scottgchin/delta5_race_timer/(threads)

Thread 1 (2017-03-24):

Update RSSI trigger function

scottgchin, 2017-03-24:
Currently if the average RSSI is above the threshold limit (or lap trigger) this counts as a good lap read.  Look into using a rising edge detection or a peak detection to determine the trigger.  The trigger calibration could still set the minimum threshold required.

For reference:
https://www.tigoe.com/pcomp/code/arduinowiring/46/

howflyquad, 2017-05-20:
I think this is complete in the current version of the code using the rssiTriggerBandwidth value.

Closed 2017-05-29.

Thread 2 (2017-04-06):

Map and constrain the RSSI value

scottgchin, 2017-04-06:
The RSSI value can be over 255 which isn't handled well by i2c unless the number is conditioned.  Possibly use the map() and constrain() functions to keep the values within range.

shamshir1972, 2017-04-08:
scottgchin,
i've setup delta5 and got prob with python script. startstop.py seem to be not running at line 78 due to i2c device not present. Im using i2c device with address 14 (address of node 4 i2c) and channel 5860 (30). I got to delete other i2c device line and only remain the code for i2c address 14. Also at line 122 (while startstop==1) i got to remove other line not related to node 4 to get everything working. Please help me

scottgchin, 2017-04-08:
If I understand you correctly, you're only using 1 node and it is using slave address 14 correct?

You need to delete the references to the other nodes because the pi is stuck waiting for a response from the arduinos (which are not there)  If that is the case you'll need to make the following changes to the startstop.py file:

Delete lines 70-72
Delete lines  74-83
Delete lines  86-104
Delete lines 111-119
Delete lines 124-194
Delete lines 220-266

scottgchin, 2017-04-12:
The arduino file has been updated to ver 0.2 with adds the mapping and constrain functions to the RSSI read function.

Closed 2017-04-12.

Thread 20 (2017-06-28):

Move Race Timing Clock to the Python Script

howflyquad, 2017-06-28:
The race timing clock is currently javascript on the race page. It does not persist if the race director navigates away from the race page and then returns. Move the timing clock to a python function with socket io updates back to the race page as needed. This might involve needed a separate emit for each audio cue as well.

punkkills, 2017-06-28:
You could have a generic "play_cue" emit with some data describing which cue to play.

howflyquad, 2017-06-28:
True, that would be the better way to do it.

Should also tie in with #18

Thread 26 (2017-07-03):

Database Clears on System Power Cycle

howflyquad, 2017-07-03:
Database resets on a power cycle when it shouldn't.

howflyquad, 2017-07-03:
It looks like the systemd service run on startup was using a temp directory which was then cleared on a power cycle. The docs have been updated to make the working directory match the main repo directory. Some testing has shown the database to now persist after a hard power loss.

Closed 2017-07-03.

Thread 45 (2017-07-20):

Calibrated each node

sniperxnl, 2017-07-20:
Maby a idear,that we can calibrate each node, so the quality diffrence is not a issue anymore

jrob3rts, 2018-04-25:
I think this would be a brilliant fix / change if possible as we are seeing the variations in the boards are causing some mis reads.

Thread 50 (2017-10-15):

Discard or highlight falsey laps

ntgussoni, 2017-10-15:
Add a method to mark or directly discard falsey laps.
Add a minimum lap time value to the race config.

Eg. A lap for some track cannot be less than 5 seconds so we mark it in order to delete it easily.
We could also add a bulk delete button with those times

ntgussoni, 2017-10-15:
I'll do this feature when I have the time

scottgchin, 2017-10-15:
On the default GUI, you can already delete laps, there is an 'x' that shows up next to each lap.

Nandox7, 2018-06-16:
@ntgussoni did you end up doing anything?
I'm also interested in adding a feature to automatically discard false laps (less that n time).

ntgussoni, 2018-06-19:
I completely forgot about this. I hacen't used the timer in a while but this shouldn't be difficult to do.
Not promising anything, but i'll try to do it

Thread 54 (2018-01-01):

Automated Rasberry Pi images

spuder, 2018-01-01:
It would be nice to have a pre-built raspberry pi image.

pi-gen is the tool used to generate the pre built images on raspberrypi.org

https://github.com/RPi-Distro/pi-gen

scottgchin, 2018-01-01:
Sorry if I'm a bit slow, but help me understand what this does?
it creates an .img for easy installation?

spuder, 2018-01-01:
Correct, so instead of people needing to install the software manually, they just download a .img to a sd card, plug it in and everything is up and running.

Some example projects that ship pre-built images for raspberry-pi.

[octopi](https://octopi.octoprint.org/)
[astrobox](https://astroprint.zendesk.com/hc/en-us/articles/202638365-Raspberry-Pi-Flashing-the-AstroBox-image-onto-an-SD-card)

I'm interested in helping with this.

spuder, 2018-01-04:
The home assistant (hasbian) raspberry pi image is the best example. Steps to implement:

1. Fork the pi-gen image (I'll do this in my own fork for now, eventually it may be best to move it under a delta 5 organization)
2. Remove folders [stage 3,4,5] replace with own scripts to install and configure app
3. setup travis-ci to build a new image based on a schedule/event (weekly?, on merge to master?, whenever you feel like it)
4. Update documentation showing where to download images ([hasbian images](https://github.com/home-assistant/pi-gen/tree/v1.31) are 300-400mb which should be hostable on github)
5. Profit??

scottgchin, 2018-01-04:
Cool.  I'll take a look at it when I get a chance.  I already posted the latest image of my SD card on the facebook page to make it easier for people to install.

spuder, 2018-01-04:
I've nearly got the automated images working. They are on my delta5 branch in my fork. The bulk of the script is in step 3

https://github.com/spuder/pi-gen/tree/delta5

It is copied from the home-assistant project

https://github.com/home-assistant/pi-gen

spuder, 2018-01-05:
I've successfully got automated images building on my repo

https://github.com/spuder/pi-gen

    ./build-docker.sh

Depending on your internet speed, you will then have an image in about 30 minutes.

The image is idential to a stock raspbian with the following changes.

- source is cloned to /opt/delta5
- dedicated user to run service
- locale = US not GB (still buggy)
- nginx reverse proxy to forward port 80 to 5000
- i2c kernel modules

It will build a 456MB file. Use a program like etcher to drop it on an sd card, plug it in and wait 5 minutes and delta 5 will be running.

## Next steps

- Transfer git repo to delta 5 project ownership
- setup travis-ci to build images every time delta 5 has a new release
- document how to use

spuder, 2018-01-09:
I've got an image up on github. The biggest advantage to it is that it has UK keyboard and locale settings.

https://github.com/spuder/pi-gen/releases

scottgchin, 2018-01-13:
Sorry about the delay, Just now starting to go through this.  This looks pretty cool!  So how is the image creation triggered?  Is it each time there is a release?

spuder, 2018-01-13:
That part still hasn’t been automated yet. Currently you need to install
Docker and then run the build-docker.sh script.

I’ve manually uploaded two images to github so far

Depending on how frequently delta 5 is released will determine how to
automate the raspberry pi image with Travis ci.

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

h4rr21, 2018-02-01:
Hi spuder, I understand that part of the idea it's to make easy to deploy de code to the raspi.

But what about "https://resin.io" shouldn't be easy to deploy if delta5 runs in a docker container with resin.io rather than uploading a complete new image each time it releases a new one?

BTW I'm interested in helping to adopt CI tools in this project...

spuder, 2018-02-01:
There may be a place for resin.io, however that is more intended for IOT projects. Delta 5 is very often run without internet access. Also delta5 doesn't run in a docker container currently, it only uses docker to build the image that goes on the SD card.

As far as I'm concerned, the raspberry pi images are working, you can get them here:

https://github.com/spuder/pi-gen/releases

Since delta 5 isn't releasing new versions very often, there isn't a need net for a more automated update process (yet).

h4rr21, 2018-03-04:
What's the login user and password? For this images?

BoLtWD, 2018-09-27:
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

This is fantastic work to help someone get going as setting up the Pi can be daunting.

Thread 57 (2018-01-08):

Lipo Voltage Monitoring

jafc76, 2018-01-08:
Would be nice to have that option to check the Li-Po voltage and an alert when the voltage is low.
I know that it needs a PCB modification but could be easy to make.

dronemesh, 2018-01-27:
Im currently working on a new PCB design with all smd components which should be ready within a couple weeks. If you are interested

Thread 60 (2018-01-17):

How does it integrate with live time?

spuder, 2018-01-17:
I'm just learning what live time is. The documentation says

>Alternatively, to use your Delta5 Race Timer hardware with 3rd party timing software, replace each reference of 'delta5server' with 'timingserver' in the following instructions.

Does live time run on the raspberry pi?

There have been some facebook discussions around switching between the delta 5 server and live time. I'm trying to figure out if there is a way to run both services simultaneously and use a proxy to route network traffic based on the source url.

Could you elaborate on why there is a need for 2 different services to be running?

punkkills, 2018-01-18:
Livetime runs on a PC and communicates with the pi through the TimingServer.  The TimingServer does not have any more advanced features such as managing pilots and heats.  The delta5server is a race management tool.  It runs as a web app and provides a subset of the functionality of something like Livetime.  They have different requirements and goals so they are different apps.  They do run shared code for communicating with the arduinos.

Closed 2018-01-29.

Thread 77 (2018-04-09):

RSSI not working correctly

ManCubFPV, 2018-04-09:
I have everything built and programmed as instructed. When I'm the GUI for LiveTime it shows all the nodes at 570(+-5) and no changes or spikes when I power up a transmitter. What'd I do wrong?

ManCubFPV, 2018-04-09:
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

scottgchin, 2018-04-09:
Those RSSI values are really high; they are normally below 300.  The stranger part is that they all have the same value.

The working RSSI range on my unit is roughly 100-250.  With no vtx powered on, the RSSI floor is around 60-80.  Any chance you can provide details on the equipment you're using and how you have it wired?

scottgchin, 2018-04-09:
Looking at the image above. Connect the outside ground on the PCB to the receiver, that's the active ground.  It needs that ground for a common reference point.  I wrote that up in the description when the pcb was first released.   If you followed Deep Impacts video, he went back and clarified to connect all the pins.

ManCubFPV, 2018-04-09:
Thank you so much! I don't know how I missed that. Also thank you for all
the hard work on this and your quick responses.

Casey Pinochi
541-971-7763
Casey.Pinochi@gmail.com

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

scottgchin, 2018-04-09:
No problem.  Let me know if that fixes it, or if you come across any other issues.

ManCubFPV, 2018-04-09:
On a side note, know anyone that wants the v2 PCB? I have 6 extra

Casey Pinochi
541-971-7763
Casey.Pinochi@gmail.com

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

ManCubFPV, 2018-04-09:
I share Facebook with my good half. It's kind of a pain for me to use. You
can either text me at the number below or email me at the email below.

Casey Pinochi
541-971-7763
Casey.Pinochi@gmail.com

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

ManCubFPV, 2018-04-10:
is there anyway to pull the video feed from the delta 5?

On Mon, Apr 9, 2018 at 8:24 AM, Casey Pinochi <casey.pinochi@gmail.com>
wrote:

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

--

Casey Pinochi
530-228-6609
Casey.Pinochi@gmail.com

scottgchin, 2018-04-10:
Well... I haven't tried it yet, but I want to just to see what happens.  But, the premise of the timer is that away from the receivers, the RSSI would be really low and really high when the quad is passing over.  It's one of the reasons for not adding an antenna.  So at the far points of the track, I'm not sure the video would be very good.

Thread 81 (2018-08-01):

Improve phonetic readout of lap + time

fahrvergnuugen, 2018-08-01:
Right now the phonetic readout of the pilot plus lap plus time is a bit hard to comprehend because the lap number bleeds into the time.

**Example: "Paul lap one one minute five seconds"**

I believe this is the line responsible:

https://github.com/scottgchin/delta5_race_timer/blob/47a35739f8de409c27af11655828dc35512c076c/src/delta5server/templates/race.html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

I am going to try modifying this function on our timer to something like this (to be tested still):
```
		socket.on('phonetic_data', function (msg) {
			//	var $ttstest = msg.pilot + " lap " + msg.lap + " " + msg.phonetic;

			var phoneticLap="";
			switch(msg.lap){
				case 1: phoneticLap = "st"; break;
				case 2: phoneticLap = "nd"; break;
				case 3: phoneticLap = "rd"; break;
				default: phoneticLap = "th"; break;
			}
			var $ttstest = msg.pilot + msg.lap + phoneticLap + " lap " + msg.lap + " " + msg.phonetic;

			speak('<div class="speech">' + $ttstest + '</div> div.speech');
		})
```

That should hopefully cause it to say: **"Paul first lap one minute five seconds"**

Thread 82 (2018-08-01):

iOS speech support

fahrvergnuugen, 2018-08-01:
For some reason the speech doesn't work on iOS devices. I believe this can be fixed since https://responsivevoice.org works on iOS.

Cuxx, 2018-08-01:
It's a safari related problem. Sounds are working with Chrome.

DevertNet, 2018-12-11:
iOS needs a user interaction to allow speech.
I don't know why e.g. the play-button in the settings not work, but i have found a workaround:

Open src/delta5server/templates/layout.html.
After `{% block content %}{% endblock %}` add the following code in a new line:
`<a href="#" onclick="speak('<div class=timer>Ready</div>');">Allow iOS Speech</a><br /><br />`

You must click on "Allow iOS Speech" first, than speech works :)

scottgchin, 2018-12-11:
Cool.  I'll try it out when I get a chance.  It's an iOS issue where the user has to interface with the page before sound is allowed to play.

Thread 84 (2018-08-20):

list index out of range

spuder, 2018-08-20:
The delta5 timer was working yesterday, but today when I try and start it, the service exits with error `list index out of range`

```
journalctl -xe
.....
Aug 20 02:34:01 delta5 python[724]: No node at address 8
Aug 20 02:34:01 delta5 python[724]: Node FOUND at address 10
Aug 20 02:34:01 delta5 python[724]: Node FOUND at address 12
Aug 20 02:34:01 delta5 python[724]: Node FOUND at address 14
Aug 20 02:34:01 delta5 python[724]: No node at address 16
Aug 20 02:34:01 delta5 python[724]: No node at address 18
Aug 20 02:34:01 delta5 python[724]: No node at address 20
Aug 20 02:34:01 delta5 python[724]: No node at address 22
Aug 20 02:34:01 delta5 python[724]: Traceback (most recent call last):
Aug 20 02:34:01 delta5 python[724]:   File "server.py", line 33, in <module>
Aug 20 02:34:01 delta5 python[724]:     INTERFACE = get_hardware_interface()
Aug 20 02:34:01 delta5 python[724]:   File "../delta5interface/Delta5Interface.py", line 343, in get_hardware_interface
Aug 20 02:34:01 delta5 python[724]:     return Delta5Interface()
Aug 20 02:34:01 delta5 python[724]:   File "../delta5interface/Delta5Interface.py", line 104, in __init__
Aug 20 02:34:01 delta5 python[724]:     self.set_calibration_threshold(node.index, self.calibration_threshold)
Aug 20 02:34:01 delta5 python[724]:   File "../delta5interface/Delta5Interface.py", line 270, in set_calibration_threshold
Aug 20 02:34:01 delta5 python[724]:     node = self.nodes[node_index]
Aug 20 02:34:01 delta5 python[724]: IndexError: list index out of range
Aug 20 02:34:01 delta5 systemd[1]: delta5.service: Main process exited, code=exited, status=1/FAILURE
Aug 20 02:34:01 delta5 systemd[1]: delta5.service: Unit entered failed state.
Aug 20 02:34:01 delta5 systemd[1]: delta5.service: Failed with result 'exit-code'.
Aug 20 02:34:07 delta5 kernel: Voltage normalised (0x00000000)
```

Not sure how to recover from this. How does `self.nodes[node_index]` go out of range?

scottgchin, 2018-08-20:
It doesn't like that the first node is missing.  Check the connections on that node, it's not talking to the pi over i2c

Closed 2018-08-21.

Thread 85 (2018-08-21):

reset database doesn't work

spuder, 2018-08-21:
Running the latest code as of a couple of days ago. When I click 'reset database' it asks me to login and then refreshes the page, but the database didn't reset because I still see pilots and heats.

47a35739f8de409c27af11655828dc35512c076c

spuder, 2018-08-21:
Looking at the logs, it now gives me error

     'NoneType' object has no attribute 'pilot_id'

```
root@delta5:/opt/delta5# systemctl status delta5.service
● delta5.service - Delta5 Server
   Loaded: loaded (/lib/systemd/system/delta5.service; enabled; vendor preset: enabled)
   Active: active (running) since Tue 2018-08-21 01:47:26 UTC; 42s ago
 Main PID: 943 (python)
   CGroup: /system.slice/delta5.service
           ├─943 /usr/bin/python server.py
           └─949 /usr/bin/python server.py

Aug 21 01:48:05 delta5 python[943]:     return self.handlers[namespace][event](*args)
Aug 21 01:48:05 delta5 python[943]:   File "/usr/local/lib/python2.7/dist-packages/flask_socketio/__init__.py", line 2
Aug 21 01:48:05 delta5 python[943]:     *args)
Aug 21 01:48:05 delta5 python[943]:   File "/usr/local/lib/python2.7/dist-packages/flask_socketio/__init__.py", line 6
Aug 21 01:48:05 delta5 python[943]:     ret = handler()
Aug 21 01:48:05 delta5 python[943]:   File "server.py", line 258, in connect_handler
Aug 21 01:48:05 delta5 python[943]:     emit_leaderboard() # Race page, load leaderboard for current laps
Aug 21 01:48:05 delta5 python[943]:   File "server.py", line 721, in emit_leaderboard
Aug 21 01:48:05 delta5 python[943]:     heat_id=RACE.current_heat, node_index=node).first().pilot_id
Aug 21 01:48:05 delta5 python[943]: AttributeError: 'NoneType' object has no attribute 'pilot_id'
```

Cerberus74, 2018-08-26:
+1

Am experiencing same behaviour on a newly built set up.

Cerberus74, 2018-08-26:
Stopped service
Removed /home/pi/delta5_race_timer/src/deltaserver/database.db
Started service

Problem solved!

Thread 86 (2018-10-08):

Delete the database so you can start again if there is a problem the delta5server GUI.

BoLtWD, 2018-10-08:
I would like to see in the delta5server GUI a way to delete the database and restart the PI so you can start again if there is a problem.

Thread 88 (2018-11-05):

hacker's question

alto777, 2018-11-05:
I am delighted to find this excellent project.

In delta5node.ino it looks like there is a hard-coded i2cSlaveAddress. This is used for wire initialization, it is also printed for our convenience.

But there is also a mechanism for the master controller to interrogate the slave nodes for that address… but to do this, the address would already be known.

Car 54, what is your car number?

Or I am missing something probably. Is there a kind of master broadcast that is used to find all slaves?

alto777

scottgchin, 2018-11-07:
Not sure I understand what you're asking.

alto777, 2018-11-13:
Why is there a command to interrogate the slave for its address

when

in order to interrogate a slave, its address must already be known?

ntgussoni, 2018-11-13:
I guess it's because you can add N number of nodes with different IDs , and you don't need to change the main code if you do so. That's why it's "searching" for nodes in the BUS.

alto777, 2018-12-11:
Then I must not understand I2C.

Can an I2C slave respond to packets that do not know its address? I find "general call" googling, but don't see how it could be employed in any scanning process.

If you need to know the adderss of a slave to talk to it, why would one of the things you can ask it be its address?

I anticipate again being not understood, so another anaolgy: call 1-800-555-1212 and ask then what number you dialed. You already know!

a7

ntgussoni, 2018-12-11:
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

Here's an interesting reading.  https://howtomechatronics.com/tutorials/arduino/how-i2c-communication-works-and-how-to-use-it-with-arduino/

But long story short,  you need to know the address of the device in order to comunicate with it.

Imagine you add N numbers of nodes, each an everyone with a different address, if you don't have a way of finding them automatically then you'd have to enter each an everyone by hand so that the software recognizes them.
But instead you can scan a range of addresses (max of 8 in this case), and store them them whenever you get an ACK.
You don't know if the user is going to have 2, 4 , 8 or maybe just one. Plus, if we decide to support more, we can just go and add new addresses to the array.

https://github.com/scottgchin/delta5_race_timer/blob/47a35739f8de409c27af11655828dc35512c076c/src/delta5interface/Delta5Interface.py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

alto777, 2018-12-11:
Thank you. The READ_ADDRESS command appears to only be used to see if the device is there. Any other command would have sufficed. By either succeeding or failing the presence of a node can be determined.

Or I am still missing something - is there anything about READ_ADDRESS that makes it uniquely work for detecting?

The "report your own address" feature of a device that must be addressed to get a report seems odd.

a7

Thread 89 (2018-11-07):

Restore previous 'delta5node.ino'

ethomas997, 2018-11-07:
Commit d17dcdf43f90741d451240af1effb84ca40a5932 ("timing server LED") reverts the changes to 'delta5node.ino' that came in via the previous commit d0df60163cc21c1b55e4afff656acef83826c2ed ("Modified node to use freqMhzToRegVal() fn instead of table") for no apparent reason.  I think the [previous 'delta5node.ino'](https://github.com/scottgchin/delta5_race_timer/blob/d0df60163cc21c1b55e4afff656acef83826c2ed/src/delta5node/delta5node.ino) should be restored.

--ET

scottgchin, 2018-11-07:
It was updated because on the LiveTime version, the user can manually input the frequency.  If the user submitted a frequency that wasn't in the table the system would lock up.  Is there an issue with using the current freqMhzToRegVal() calculation?

scottgchin, 2018-11-07:
It should be restored now.

ethomas997, 2018-11-07:
Yes, looks good now; thx.

Closed 2018-11-07.

Thread 90 (2018-11-27):

Issue Getting Delta5 to work

blakermchale, 2018-11-27:
I've been trying to get the app to run by following the Software Setup Guide, but when in the settings this error keeps occurring.
This only happens in the settings, and I'm unable to add pilots or heats.
None of python files were changed after cloning

Any help would be appreciated.
Thanks.

```
Client connected
connect handler error
Traceback (most recent call last):
  File "/usr/local/lib/python2.7/dist-packages/engineio/server.py", line 423, in _trigger_event
    return self.handlers[event](*args)
  File "/usr/local/lib/python2.7/dist-packages/socketio/server.py", line 503, in _handle_eio_connect
    return self._handle_connect(sid, '/')
  File "/usr/local/lib/python2.7/dist-packages/socketio/server.py", line 421, in _handle_connect
    self.environ[sid]) is False:
  File "/usr/local/lib/python2.7/dist-packages/socketio/server.py", line 490, in _trigger_event
    return self.handlers[namespace][event](*args)
  File "/usr/local/lib/python2.7/dist-packages/flask_socketio/__init__.py", line 251, in _handler
    *args)
  File "/usr/local/lib/python2.7/dist-packages/flask_socketio/__init__.py", line 632, in _handle_event
    ret = handler()
  File "server.py", line 339, in connect_handler
    emit_leaderboard() # Race page, load leaderboard for current laps
  File "server.py", line 835, in emit_leaderboard
    heat_id=RACE.current_heat, node_index=node).first().pilot_id
AttributeError: 'NoneType' object has no attribute 'pilot_id'

```

floriangaller, 2018-11-28:
Hello,

I can confim that I have the same issue: I started with a clean install of raspbian strech Version: November 2018 Release date: 2018-11-13 and installed Delta 5 according to the instructions :"Hardware and Software Setup Instructions". I also tried different browsers: Firefox, Chrome still the same issue. I'm also unable to shut down the raspi by the gui buttons. Furthermore, all the calibration values fields are empty. The connection to the arduinos seems to work fine... (when i connect them they get shown in the setting tab. However, it is not possible to assign frequencies.)
Also the timingserver used for the connection to Livetime doesn't work.

If anybody can offer help it would be highly appreciated

Thanks

scottgchin, 2018-11-29:
Did you notice any errors during the requirements.txt install portion?  If you're looking for an easier method, there is an sd card image file made from my install on the pinned post of the facebook post.  Just write it to your sd card, and it should have everything configured.  Just a note my sd card was a 32gb card.

floriangaller, 2018-11-29:
I didn't noticed any errory during the install of requirements.txt and if i ran this command again it wirtes out that everything is installed... I have no facebook account and, therfore, i will try now the image from https://github.com/spuder/pi-gen

martinglass, 2020-01-11:
> Did you notice any errors during the requirements.txt install portion? If you're looking for an easier method, there is an sd card image file made from my install on the pinned post of the facebook post. Just write it to your sd card, and it should have everything configured. Just a note my sd card was a 32gb card.

Hi Scott, I'm getting similar issues. I also got an error installing cffi. Here's the error output....

    copying cffi/pkgconfig.py -> build/lib.linux-armv7l-2.7/cffi
    copying cffi/_cffi_include.h -> build/lib.linux-armv7l-2.7/cffi
    copying cffi/parse_c_type.h -> build/lib.linux-armv7l-2.7/cffi
    copying cffi/_embedding.h -> build/lib.linux-armv7l-2.7/cffi
    copying cffi/_cffi_errors.h -> build/lib.linux-armv7l-2.7/cffi
    running build_ext
    building '_cffi_backend' extension
    creating build/temp.linux-armv7l-2.7
    creating build/temp.linux-armv7l-2.7/c
    arm-linux-gnueabihf-gcc -pthread -DNDEBUG -g -fwrapv -O2 -Wall -Wstrict-prototypes -fno-strict-aliasing -Wdate-time -D_FORTIFY_SOURCE=2 -g -fdebug-prefix-map=/build/python2.7-9NJ3qw/python2.7-2.7.16=. -fstack-protector-strong -Wformat -Werror=format-security -fPIC -DUSE__THREAD -DHAVE_SYNC_SYNCHRONIZE -I/usr/include/ffi -I/usr/include/libffi -I/usr/include/python2.7 -c c/_cffi_backend.c -o build/temp.linux-armv7l-2.7/c/_cffi_backend.o
    c/_cffi_backend.c:15:10: fatal error: ffi.h: No such file or directory
     #include <ffi.h>
              ^~~~~~~
    compilation terminated.
    error: command 'arm-linux-gnueabihf-gcc' failed with exit status 1

    ----------------------------------------
Command "/usr/bin/python -u -c "import setuptools, tokenize;__file__='/tmp/pip-install-Eu7j9K/cffi/setup.py';f=getattr(tokenize, 'open', open)(__file__);code=f.read().replace('\r\n', '\n');f.close();exec(compile(code, __file__, 'exec'))" install --record /tmp/pip-record-H6hxph/install-record.txt --single-version-externally-managed --compile" failed with error code 1 in /tmp/pip-install-Eu7j9K/cffi/

Thread 91 (2018-12-11):

receiver swamped

alto777, 2018-12-11:
I am experimenting with the Delta5 concept and I observe that the RSSI from my receiver achieves a maximum output with the transmitter some distnace away - there is nothing like a peak to detect, it is a plateau.

So I came looking for a way to desensitize the receiver. Since I know nothing about RF, my experiments were only amusing failures. Never mind.

Or find sympathy, or assurances that it is just the truth. The implication would seem to be that Delta5 is only satifactory on larger tracks?

TIA

a7

scottgchin, 2018-12-11:
It works on smaller tracks, but it needs to be tuned down so its not so sensitive.  For your issue though it sounds like something else.  Do the receivers have the SPI mod done?  on my receivers, with nothing on they avg between 70-90 for RSSI.  When a VTX is right over the receivers, it jumps to around 180 or so.

alto777, 2018-12-11:
Yes I have the SPI. In fact, the modules I purchased were already SPI'd - opened one to discover that, then just wired the other expecting and finding that SPI is fine.

I do see variance in the RSSI depending on VTX distance from the receiver.

I see 90 background and 220 when I am very close. I see 220 from some distance, only at larger distances does it fall. Obviously it can only fall off to the background radiation. It nevers goes above a certain number, leading me to conclude the receiver is swamped.

How does one "tune down"? I was looking to reduce receiver sensitivity, perhaps you are suggesting looking at a lower or higher slightly frequency? Any suggestions for a starting offset if that was what you mean? I can experiment. Right now of course I am tuning exactly and only the numbers that are in the freq table and correspond to channels.

Step by step. THX.

a7

Thread 98 (2019-12-28):

Differences in the data the mock interface outputs vs the live one.

swampmonster, 2019-12-28:
I've been trying to get livetime to support signal strength from delta5 but since when
--mock is used that data is not there they would like the mock interface to be changed
to match the live one.

I figured i'd check in and see if there was any interest in merging such a change
or if this repo is more or less completely idle at this point.

I'm willing to write the code myself and submit a pull request if there's interest.

scottgchin, 2020-01-03:
Sorry been out of town.  I'm not sure I follow what you mean

swampmonster, 2020-01-04:
> Sorry been out of town. I'm not sure I follow what you mean

If i run the timing server with —mock the json it outputs is missing a few fields that are present when I run it “live”.

I had a discussion with live timings support about making use of the rssi_raw data to indicate the signal strength at a pass in their interface and they said that for them to add that the output from the timing server in —mock mode has to actually be representative of the data being sent when the system is “live”.

From memory when a pass is triggered while in —mock it only outputs the node and the freq while in normal working conditions it also outputs rssi_raw, rssi_peak and one or two more fields.

So my idea was to just add those values in to the simulated pass output with random data so that it mirrors what is sent during a “live” pass.

swampmonster, 2020-02-20:
I was poking around the code this morning because i was bored and i noticed that the code to do this is already in here it just isnt used in the timingserver.

https://github.com/scottgchin/delta5_race_timer/blob/master/src/delta5server/server.py#L710

Compared to:
https://github.com/scottgchin/delta5_race_timer/blob/master/src/timingserver/server.py#L243

Which emits a hardcoded json object with less data.
It looks on the surface like just changing the call in the timingserver to be the same as the other one would work but im not 100% sure on that.

Thread 99 (2021-01-02):

installation not possible with Pyhton 2

d-hartmann, 2021-01-02:
With current RaspberryPi OS (recent install von 01.01.2021, Python 2.7.16) installation stops at bidict (No matching distribution found for bidict>=0.21.0) for python-socketio.

Backu68, 2021-01-03:
I know your pain. I don't know python scripting or any of this pip language, so it took me some google-foo, but I managed to hack together my requirements.txt to do a successful install, but it's still a broken system self-controlling.. since I plan to use LiveTime, it doesn't seem to really be an issue for me.. My workaround involved editing my requirements and adjusting/adding the following:

python-engineio<4
python-socketio==4.6.1
bidict==0.18.4

It starts and runs.. delta5server doesn't do heats, it breaks, but the timingserver runs just fine.. so far.

Thread 102 (2022-02-07):

not working on rpi 4b and newest piOS

pan-sattan, 2022-02-07:
hello,
I am struggling on my raspberry pi 4B 8gb version with newest PiOS with desktop... unable to run server
there are multiple errors like flask is missing etc

Any idea how to solve it?

martinglass, 2022-02-07:
I'm not sure what support is available here anymore. If you don't get an answer (or even if you do), it maybe worth looking at Rotorhazard, which is a more up to date fork of Delta5, using the same hardware.
https://github.com/RotorHazard/RotorHazard

pan-sattan, 2022-02-10:
@martinglass thank you... rotorhazard version is realy working!
