scottgchin/delta5_race_timer/(commit log)

2019-02-12 Update server.py
    Removed LED red blink at start.
2019-02-28 Update Raspberry Pi Reference.md
